MarcOnTheMoon/cubes/docs/Lanz_2023_DeepReinforcementLearning_Poster.pdf

## Deep Reinforcement Learning zum maschinellen Erlernen von Strategien zur Lösung von Zauberwurfeln ¨

### Masterarbeit Finn Lanz Prof. Dr.-Ing. Marc Hensel und Prof. Dr. Sönke Appel

Hochschule fur Angewandte Wissenschaften Hamburg ¨ | · Fachhochschule Westkuste ¨

Der Rubik’s Cube bzw. Zauberwu¨rfel begeistert seit Jahrzehnten Menschen. Dies liegt vor allem an seinem einfachen Aufbau und seiner dennoch enormen Komplexität. Da der Wu¨rfel deutlich mehr unterschiedliche Zustände besitzt als es Menschen auf
der Erde gibt, könnte es sehr viel Zeit in Anspruch
nehmen, bis ein Mensch alleine Algorithmen entwickelt, um den Wu¨rfel aus jedem beliebigen Zustand zu lösen. Wie sieht es jedoch aus, wenn eine ku¨nstliche Intelligenz versucht, sich das kombinatorische Puzzlespiel selbst beizubringen? Anhand des kleineren Pocket Cubes und aufbauend auf wissenschaftlichen Veröffentlichungen sollen Methoden erarbeitet werden, welche später auf den Rubik’s Cube u¨bertragen werden könnten.

Deep Reinforcement Learning

Mit Hilfe von Deep Reinforcement Learning wird ein neuronales Netzwerk mittels Belohnungen (Rewards) so trainiert, dass es komplexe Entscheidungsprozesse wie das Lösen eines Zauberwu¨rfels durch eine Ketten von Handlungen (Actions) erlernt.

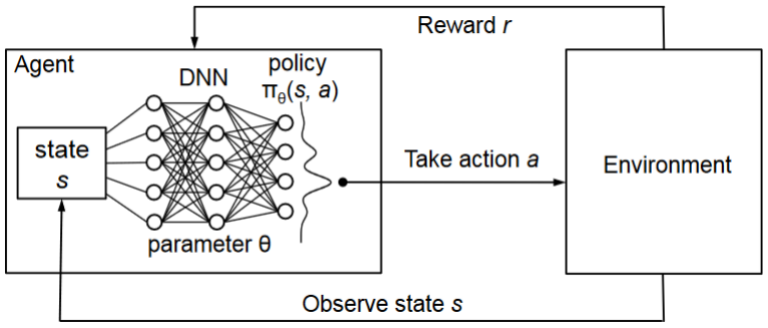
[picture p14: figure]

Image taken from: https://medium.com/@vishnuvijayanpv/deep-reinforcement-learning-artificial-intelligencemachine-learning-and-deep-learning-e52cb5974420 (Access: 02.10.2023)

Autodidaktisches Iterationsverfahren

Grundlage des Trainings bildet das Autodidaktische Iterationsverfahren, bei welchem der Wu¨rfel ausgehend vom gelösten Zustand schrittweise mit einer zufälligen Aktion weiter verdreht wird. Anschließend werden die möglichen Folgezustände jedes Zustandes mit einem neuronalen Netzwerk untersucht. Somit soll das Netz den Zusammenhang zwischen aufeinander aufbauenden Zuständen lernen, anstatt zusammenhangslos zerwu¨rfelte Zustände als Eingabe zu erhalten.

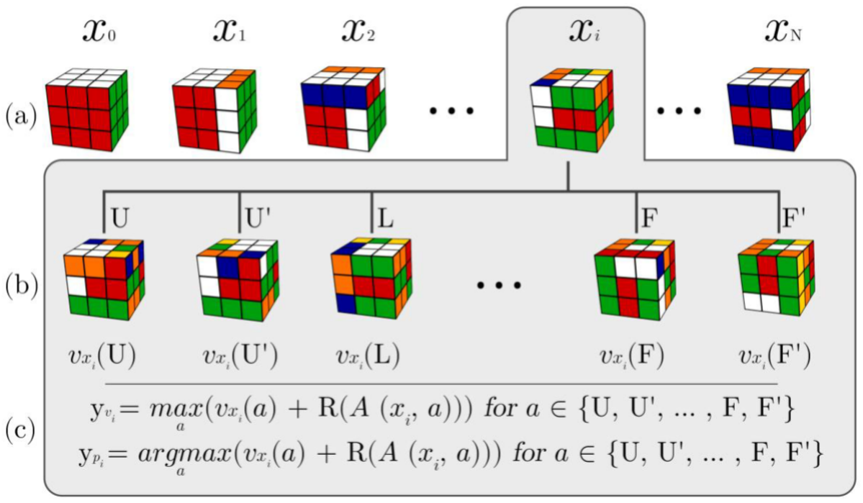
[picture p15: figure]

Image taken from: S. McAleer et al.: Solving the Rubik’s Cube with Approximate Policy Iteration. ICLR 2019.

Suchalgorithmen

Aufgrund der Komplexität und des enormen Zustandsraums des Zauberwu¨rfels ist eine alleinige Lösungswegfindung u¨ber ein neuronales Netzwerk nicht praktikabel. Daher werden neuronale Netze mit den Suchalgorithmen Monte-Carlo-Baumsuche bzw. dem A*-Algorithmus kombiniert. Hierbei wird das Netz als richtungsweisende Instanz verwendet, indem dieses Zustände des Wu¨rfels bewertet und somit vielversprechende Wege zum Zielzustand ermittelt.

Ergebnisse

Die auf Monte-Carlo-Baumsuche bzw. dem A*-Algorithmus basierenden Modelle wurden auf Wu¨rfel, die 50 mal zufällig verdreht wurden, angewendet. Beide konnte fu¨r alle Zustände einen Lösungsweg ermitteln (100% Erfolgsquote), wobei die Monte-Carlo-Baumsuche etwas weniger Rechenzeit benötigt.

Demonstrator

Begleitend zu dieser Arbeit hat Prof. Marc Hensel einen Demonstrator mitsamt Python-API entwickelt, in welchen ein Pocket Cube eingelegt und durch die Ansteuerung zweier Servomotoren beliebig verdreht werden kann.

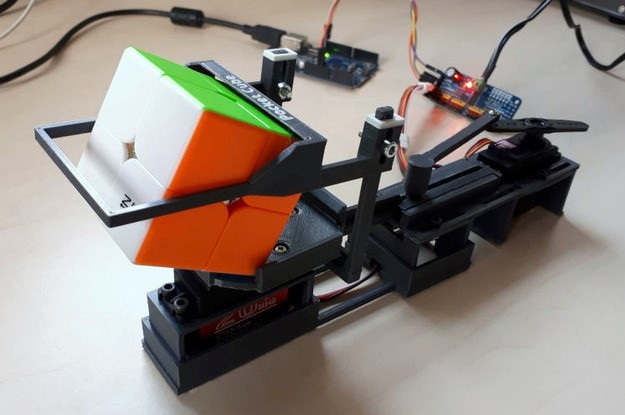
[picture p16: figure]
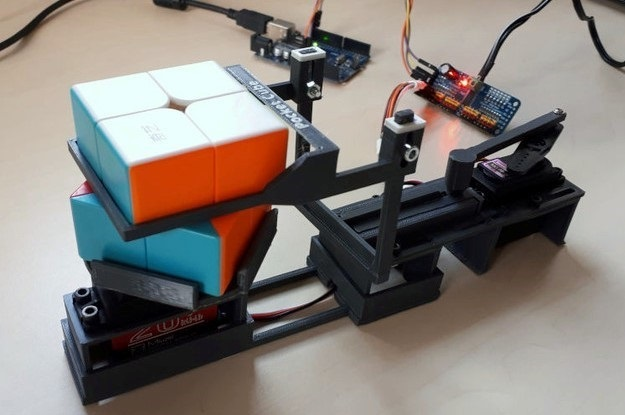
[picture p17: figure]

(a) Kippen des Wu¨rfels | (b) Rotation der unteren Seite

Bedienoberfläche

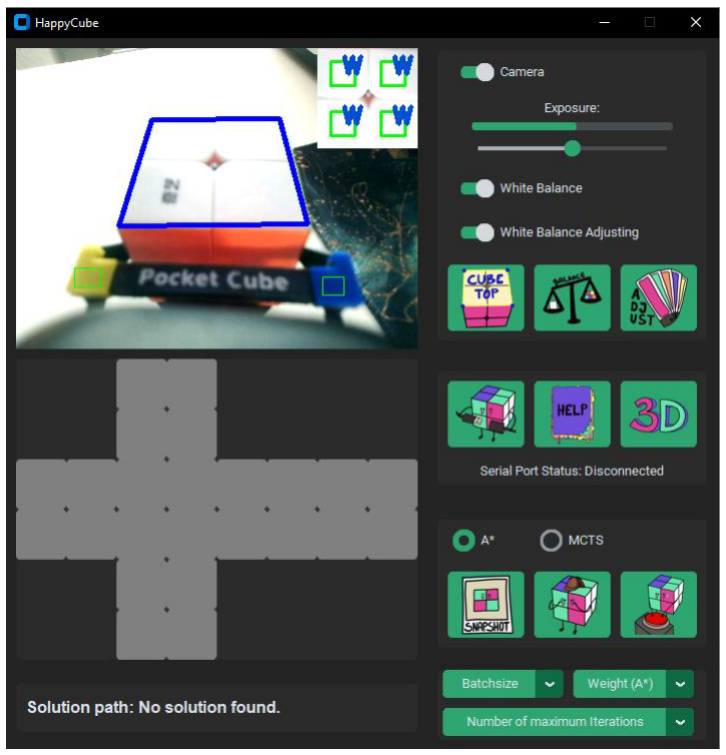
[picture p18: figure]

Der Demonstrator und die Methoden wurden in eine eigens entworfene Bedienoberfläche integriert. Durch Verwendung einer Kamera, welche auf der Hardware montiert wird, lässt sich der Wu¨rfelzustand automatisiert erfassen. Nach Findung des Lösungsweges u¨ber einen der Suchalgorithmen und das zugehörige neuronale Netzwerk wird der Wu¨rfel mittels entsprechender Bewegungsabfolgen der Servomotoren zuru¨ck in den Zielzustand versetzt.

Projektseite im Internet

Masterarbeit, 3D-Druckdateien und Dokumentation des Demonstrators, Quelltexte, Modelle und mehr werden nach und nach auf der u¨ber den QR-Code verlinkten Webseite zur Verfu¨gung gestellt.

Stand: 02.10.2023
