MarcOnTheMoon/cubes/src/pocket_cube_gym/assets/CubySolved.png

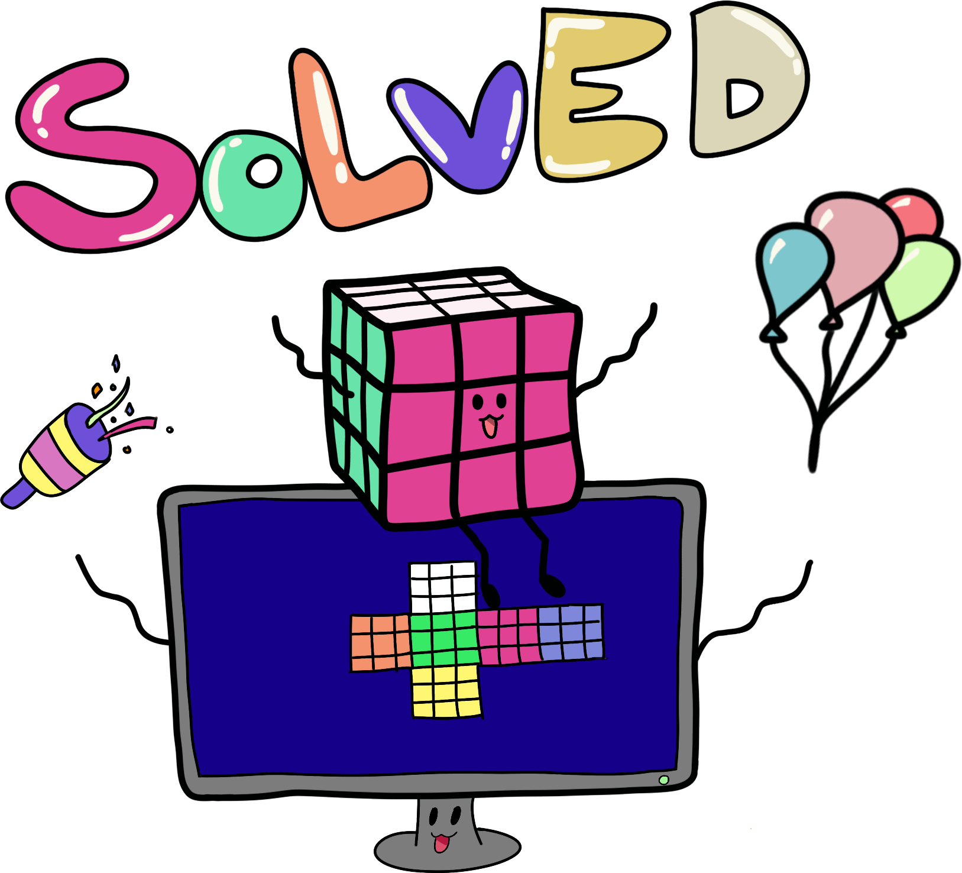
src/pocket_cube_gym/assets/CubySolved.png
