MarcOnTheMoon/cubes/uml_diagrams/pocket_cube/pocket_cube_gym_class.png

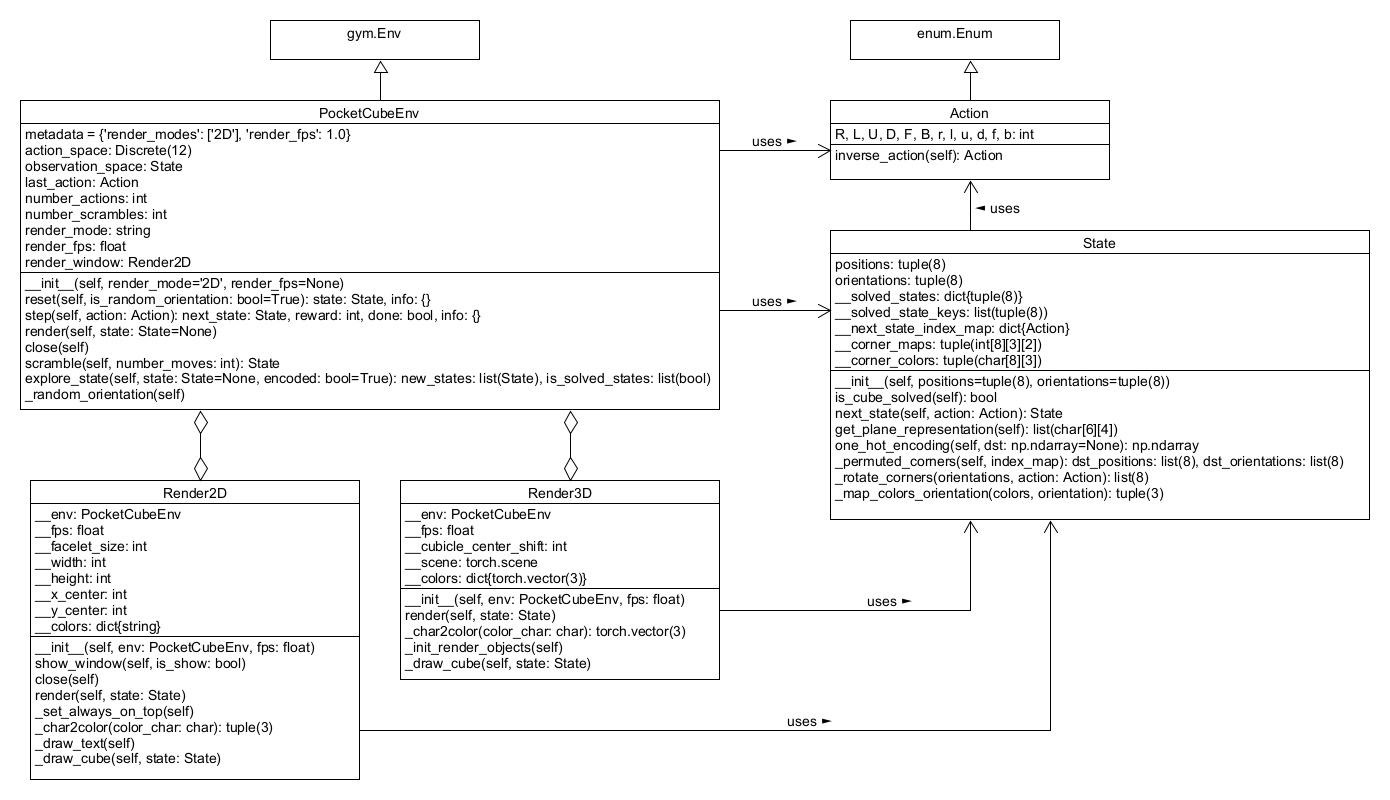
uml_diagrams/pocket_cube/pocket_cube_gym_class.png
